mungoP/ZABKA/README.md

# Ż.A.B.K.A.

**Zero-moment Assisted Bipedal Kinetic Android**

ŻABKA ("little frog" in Polish) is a DIY 3D-printed humanoid robot. The current focus is the legs.

## Planned Specs

- **Height:** 3-4 ft
- **Legs:** 6 DoF each (3 hip, 1 knee, 2 ankle), 12 DoF total
- **Actuators:** Integrated motors with built-in drivers, controlled over CAN
- **Structure:** PETG, 4 walls, 10-20% infill
- **Power:** 48V Li-ion battery
- **Estimated weight:** 14-18 kg without arms

## Status

Early planning: selecting motors and finalizing the leg design.
