mungoP/ZABKA/docs/README.md

# Docs

Datasheets, reference material, and images.
