mungoP/ZABKA/firmware/README.md

# Firmware

Firmware for both the main board as well as the individual motor controller/IMU boards.
