mungoP/ZABKA/pcb/README.md

# PCB

Contains both KiCad files for the main board and motor controller/IMU boards as well as gerber files for ordering from a PCB manufacturer.
