mungoP/ZABKA/pcb/motor_board/update-symbols-from-library-report.txt

Update symbol C22 from 'PCM_JLCPCB-Capacitors:0402,100nF' to 'PCM_JLCPCB-Capacitors:0402,100nF': OK
Update symbol R13 from 'PCM_JLCPCB-Resistors:0402,120Ω' to 'PCM_JLCPCB-Resistors:0402,120Ω': OK
Update symbol JP1 from 'Jumper:SolderJumper_2_Open' to 'Jumper:SolderJumper_2_Open': OK
Update symbol U5 from 'zabka:AS5047P-ATSM_C962063' to 'zabka:AS5047P-ATSM_C962063': OK
Update symbol C21 from 'PCM_JLCPCB-Capacitors:0402,100nF' to 'PCM_JLCPCB-Capacitors:0402,100nF': OK
Update symbol U2 from 'zabka:TCAN3414DR' to 'zabka:TCAN3414DR': OK
Update symbol R18 from 'PCM_JLCPCB-Resistors:0402,33Ω' to 'PCM_JLCPCB-Resistors:0402,33Ω': OK
Update symbol D4 from 'zabka:PESD1CAN,215' to 'zabka:PESD1CAN,215': OK
Update symbol U3 from 'zabka:SM04B-GHS-TB' to 'zabka:SM04B-GHS-TB': OK
Update symbol #PWR045 from 'power:+3V3' to 'power:+3V3': OK
Update symbol #PWR044 from 'power:GND' to 'power:GND': OK
Update symbol C23 from 'PCM_JLCPCB-Capacitors:0402,1uF' to 'PCM_JLCPCB-Capacitors:0402,1uF': OK
Update symbol C20 from 'PCM_JLCPCB-Capacitors:0402,4.7nF' to 'PCM_JLCPCB-Capacitors:0402,4.7nF': OK
Update symbol R17 from 'PCM_JLCPCB-Resistors:0402,10kΩ' to 'PCM_JLCPCB-Resistors:0402,10kΩ': OK
Update symbol #PWR019 from 'power:+3V3' to 'power:+3V3': OK
Update symbol #PWR038 from 'power:GND' to 'power:GND': OK
Update symbol #PWR037 from 'power:+3V3' to 'power:+3V3': OK
Update symbol #PWR027 from 'power:+3V3' to 'power:+3V3': OK
Update symbol #PWR07 from 'power:+3V3' to 'power:+3V3': OK
Update symbol #PWR011 from 'power:GND' to 'power:GND': OK
Update symbol #PWR024 from 'zabka:VM' to 'zabka:VM': OK
Update symbol #PWR025 from 'zabka:PGND' to 'zabka:PGND': OK
Update symbol C14 from 'PCM_JLCPCB-Capacitors:0805,4.7uF' to 'PCM_JLCPCB-Capacitors:0805,4.7uF': OK
Update symbol X1 from 'PCM_JLCPCB-Crystals:Crystal, 25MHz, 11pF' to 'PCM_JLCPCB-Crystals:Crystal, 25MHz, 11pF': OK
Update symbol J1 from 'Connector:Conn_01x05_Pin' to 'Connector:Conn_01x05_Pin': OK
Update symbol C9 from 'PCM_JLCPCB-Capacitors:1206,22uF,(2)' to 'PCM_JLCPCB-Capacitors:1206,22uF,(2)': OK
Update symbol C11 from 'PCM_JLCPCB-Capacitors:0402,100nF' to 'PCM_JLCPCB-Capacitors:0402,100nF': OK
Update symbol R7 from 'PCM_JLCPCB-Resistors:1206,100Ω' to 'PCM_JLCPCB-Resistors:1206,100Ω': OK
Update symbol #PWR018 from 'power:VCC' to 'power:VCC': OK
Update symbol C3 from 'PCM_JLCPCB-Capacitors:0402,100nF' to 'PCM_JLCPCB-Capacitors:0402,100nF': OK
Update symbol #PWR012 from 'power:GND' to 'power:GND': OK
Update symbol C6 from 'PCM_JLCPCB-Capacitors:0805,100nF' to 'PCM_JLCPCB-Capacitors:0805,100nF': OK
Update symbol #PWR021 from 'zabka:VM' to 'zabka:VM': OK
Update symbol #PWR026 from 'power:VCC' to 'power:VCC': OK
Update symbol #PWR04 from 'power:VDDA' to 'power:VDDA': OK
Update symbol FB1 from 'PCM_JLCPCB-Inductors:Ferrite,0603' to 'PCM_JLCPCB-Inductors:Ferrite,0603': OK
Update symbol #PWR010 from 'power:GND' to 'power:GND': OK
Update symbol U1 from 'zabka:STSPIN32G4_C7434864' to 'zabka:STSPIN32G4_C7434864': OK
Update symbol C8 from 'PCM_JLCPCB-Capacitors:0402,100nF' to 'PCM_JLCPCB-Capacitors:0402,100nF': OK
Update symbol #PWR03 from 'zabka:PGND' to 'zabka:PGND': OK
Update symbol #FLG01 from 'power:PWR_FLAG' to 'power:PWR_FLAG': OK
Update symbol R6 from 'PCM_JLCPCB-Resistors:1206,100Ω' to 'PCM_JLCPCB-Resistors:1206,100Ω': OK
Update symbol C5 from 'PCM_JLCPCB-Capacitors:0603,10uF' to 'PCM_JLCPCB-Capacitors:0603,10uF': OK
Update symbol R5 from 'PCM_JLCPCB-Resistors:0402,100kΩ' to 'PCM_JLCPCB-Resistors:0402,100kΩ': OK
Update symbol C2 from 'PCM_JLCPCB-Capacitors:0402,15pF' to 'PCM_JLCPCB-Capacitors:0402,15pF': OK
Update symbol #PWR023 from 'power:GND' to 'power:GND': OK
Update symbol C1 from 'PCM_JLCPCB-Capacitors:0402,15pF' to 'PCM_JLCPCB-Capacitors:0402,15pF': OK
Update symbol R1 from 'PCM_JLCPCB-Resistors:0402,1kΩ' to 'PCM_JLCPCB-Resistors:0402,1kΩ': OK
Update symbol #PWR08 from 'zabka:PGND' to 'zabka:PGND': OK
Update symbol #PWR017 from 'power:GND' to 'power:GND': OK
Update symbol R8 from 'PCM_JLCPCB-Resistors:1206,100Ω' to 'PCM_JLCPCB-Resistors:1206,100Ω': OK
Update symbol #PWR014 from 'power:GND' to 'power:GND': OK
Update symbol #PWR06 from 'power:VDDA' to 'power:VDDA': OK
Update symbol C15 from 'PCM_JLCPCB-Capacitors:0402,1uF' to 'PCM_JLCPCB-Capacitors:0402,1uF': OK
Update symbol C4 from 'PCM_JLCPCB-Capacitors:0402,100nF' to 'PCM_JLCPCB-Capacitors:0402,100nF': OK
Update symbol L1 from 'zabka:FNR6020S180MT' to 'zabka:FNR6020S180MT': OK
Update symbol R4 from 'PCM_JLCPCB-Resistors:0402,10kΩ' to 'PCM_JLCPCB-Resistors:0402,10kΩ': OK
Update symbol C7 from 'PCM_JLCPCB-Capacitors:0805,100nF' to 'PCM_JLCPCB-Capacitors:0805,100nF': OK
Update symbol #PWR01 from 'power:VDDA' to 'power:VDDA': OK
Update symbol #PWR02 from 'power:GND' to 'power:GND': OK
Update symbol #PWR020 from 'power:VCC' to 'power:VCC': OK
Update symbol D1 from 'PCM_JLCPCB-Diodes:LED,0603,Red' to 'PCM_JLCPCB-Diodes:LED,0603,Red': OK
Update symbol C13 from 'PCM_JLCPCB-Capacitors:0402,100nF' to 'PCM_JLCPCB-Capacitors:0402,100nF': OK
Update symbol C10 from 'PCM_JLCPCB-Capacitors:1206,22uF,(2)' to 'PCM_JLCPCB-Capacitors:1206,22uF,(2)': OK
Update symbol #PWR016 from 'power:GND' to 'power:GND': OK
Update symbol R3 from 'PCM_JLCPCB-Resistors:0402,22kΩ' to 'PCM_JLCPCB-Resistors:0402,22kΩ': OK
Update symbol R2 from 'PCM_JLCPCB-Resistors:0402,10kΩ' to 'PCM_JLCPCB-Resistors:0402,10kΩ': OK
Update symbol #PWR05 from 'power:GND' to 'power:GND': OK
Update symbol #FLG02 from 'power:PWR_FLAG' to 'power:PWR_FLAG': OK
Update symbol C12 from 'PCM_JLCPCB-Capacitors:0402,1uF' to 'PCM_JLCPCB-Capacitors:0402,1uF': OK
Update symbol #PWR013 from 'power:GND' to 'power:GND': OK
Update symbol D2 from 'Diode:SS210' to 'Diode:SS210': OK
Update symbol #PWR09 from 'power:GND' to 'power:GND': OK
Update symbol #PWR029 from 'zabka:VM' to 'zabka:VM': OK
Update symbol TH1 from 'Device:Thermistor_NTC' to 'Device:Thermistor_NTC': OK
Update symbol #PWR034 from 'power:GND' to 'power:GND': OK
Update symbol D3 from 'PCM_JLCPCB-Diodes:TVS-Bi,SMCJ54CA' to 'PCM_JLCPCB-Diodes:TVS-Bi,SMCJ54CA': OK
Update symbol #PWR031 from 'zabka:VM' to 'zabka:VM': OK
Update symbol J2 from 'Connector:Conn_01x02_Pin' to 'Connector:Conn_01x02_Pin': OK
Update symbol R11 from 'PCM_JLCPCB-Resistors:0603,75kΩ' to 'PCM_JLCPCB-Resistors:0603,75kΩ': OK
Update symbol #PWR032 from 'zabka:PGND' to 'zabka:PGND': OK
Update symbol #PWR035 from 'zabka:VM' to 'zabka:VM': OK
Update symbol J3 from 'Connector:Conn_01x02_Pin' to 'Connector:Conn_01x02_Pin': OK
Update symbol C17 from 'zabka:NXA63VB470M12.5*25_LO' to 'zabka:NXA63VB470M12.5*25_LO': OK
Update symbol C18 from 'PCM_JLCPCB-Capacitors:0603,33nF' to 'PCM_JLCPCB-Capacitors:0603,33nF': OK
Update symbol #FLG03 from 'power:PWR_FLAG' to 'power:PWR_FLAG': OK
Update symbol R9 from 'PCM_JLCPCB-Resistors:0402,10kΩ' to 'PCM_JLCPCB-Resistors:0402,10kΩ': OK
Update symbol C19 from 'PCM_JLCPCB-Capacitors:0603,33nF' to 'PCM_JLCPCB-Capacitors:0603,33nF': OK
Update symbol R10 from 'PCM_JLCPCB-Resistors:0402,10kΩ' to 'PCM_JLCPCB-Resistors:0402,10kΩ': OK
Update symbol TP1 from 'Connector:TestPoint' to 'Connector:TestPoint': OK
Update symbol #PWR028 from 'power:GND' to 'power:GND': OK
Update symbol #PWR030 from 'zabka:PGND' to 'zabka:PGND': OK
Update symbol TP2 from 'Connector:TestPoint' to 'Connector:TestPoint': OK
Update symbol C16 from 'PCM_JLCPCB-Capacitors:0603,33nF' to 'PCM_JLCPCB-Capacitors:0603,33nF': OK
Update symbol R12 from 'PCM_JLCPCB-Resistors:0603,3kΩ' to 'PCM_JLCPCB-Resistors:0603,3kΩ': OK
Update symbol #PWR036 from 'power:GND' to 'power:GND': OK
Update symbol #FLG04 from 'power:PWR_FLAG' to 'power:PWR_FLAG': OK
Update symbol #PWR039 from 'power:GND' to 'power:GND': OK
Update symbol U4 from 'zabka:SM04B-GHS-TB' to 'zabka:SM04B-GHS-TB': OK
Update symbol #PWR041 from 'power:GND' to 'power:GND': OK
Update symbol #PWR040 from 'power:GND' to 'power:GND': OK
Update symbol #PWR049 from 'power:+3V3' to 'power:+3V3': OK
Update symbol #PWR046 from 'power:+3V3' to 'power:+3V3': OK
Update symbol R19 from 'PCM_JLCPCB-Resistors:0402,33Ω' to 'PCM_JLCPCB-Resistors:0402,33Ω': OK
Update symbol #PWR048 from 'power:GND' to 'power:GND': OK
Update symbol #PWR042 from 'power:GND' to 'power:GND': OK
Update symbol #PWR022 from 'power:+3V3' to 'power:+3V3': OK
Update symbol #PWR033 from 'power:+3V3' to 'power:+3V3': OK
Update symbol #PWR015 from 'power:+3V3' to 'power:+3V3': OK
Update symbol R20 from 'PCM_JLCPCB-Resistors:0402,33Ω' to 'PCM_JLCPCB-Resistors:0402,33Ω': OK
Update symbol #PWR047 from 'power:GND' to 'power:GND': OK
Update symbol R15 from 'PCM_JLCPCB-Resistors:0402,120Ω' to 'PCM_JLCPCB-Resistors:0402,120Ω': OK
Update symbol R16 from 'PCM_JLCPCB-Resistors:0402,120Ω' to 'PCM_JLCPCB-Resistors:0402,120Ω': OK
Update symbol R14 from 'PCM_JLCPCB-Resistors:0402,120Ω' to 'PCM_JLCPCB-Resistors:0402,120Ω': OK
Update symbol JP2 from 'Jumper:SolderJumper_2_Open' to 'Jumper:SolderJumper_2_Open': OK
Update symbol #PWR043 from 'power:GND' to 'power:GND': OK
