mungoP/ZABKA/docs/ZABKA_sketch1.jpeg

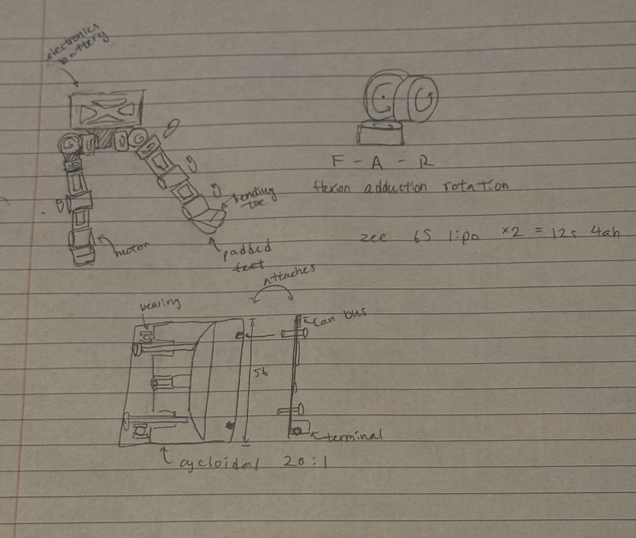
docs/ZABKA_sketch1.jpeg
