mungoP/ZABKA/BOM_ggl_sheet.md

# BOM File

Link to Google sheets BOM csv (to keep cell math formulas)

https://docs.google.com/spreadsheets/d/1IvTHRRW_kaQCn1X5jmZqQL5CsmA0eXGoDoHb6eFF2dk/edit?gid=0#gid=0
