mungoP/ZABKA/BOM.csv

Part | Price | Quantity | Total Price
MAD 5008 170KV BLDC Motor | $75.99 | 10 | $759.90
6S Lipo Battery 4000mAh 22.2V | $122.99 | 1 | $122.99
 |  |  | $0.00
 |  |  | $0.00
 |  |  | $0.00
 |  |  | $0.00
 |  |  | $0.00
 |  |  | $0.00
 |  |  | $0.00
 |  |  | $0.00
 |  |  | $0.00
 |  |  | $0.00
 |  |  | $0.00
