mungoP/ZABKA/pcb/motor_board/motor_board.csv

Reference | Qty | Value | DNP | Exclude from BOM | Exclude from Board | Footprint | Datasheet
C1,C2 | 2 | 15pF |  |  |  | PCM_JLCPCB:C_0402 | https://www.lcsc.com/datasheet/lcsc_datasheet_2304140030_FH--Guangdong-Fenghua-Advanced-Tech-0402CG150J500NT_C1548.pdf
C3,C4,C8,C11,C13,C21,C22 | 7 | 100nF |  |  |  | PCM_JLCPCB:C_0402 | https://www.lcsc.com/datasheet/lcsc_datasheet_2304140030_Samsung-Electro-Mechanics-CL05B104KO5NNNC_C1525.pdf
C5 | 1 | 10uF |  |  |  | PCM_JLCPCB:C_0603 | https://www.lcsc.com/datasheet/lcsc_datasheet_2304140030_Samsung-Electro-Mechanics-CL10A106KP8NNNC_C19702.pdf
C6,C7,C103,C203,C303 | 5 | 100nF |  |  |  | PCM_JLCPCB:C_0805 | https://www.lcsc.com/datasheet/lcsc_datasheet_2304140030_Samsung-Electro-Mechanics-CL21B104KCFNNNE_C28233.pdf
C9,C10 | 2 | 22uF |  |  |  | PCM_JLCPCB:C_1206 | https://www.lcsc.com/datasheet/lcsc_datasheet_2304140030_Samsung-Electro-Mechanics-CL31A226KAHNNNE_C12891.pdf
C12,C15,C23 | 3 | 1uF |  |  |  | PCM_JLCPCB:C_0402 | https://www.lcsc.com/datasheet/lcsc_datasheet_2304140030_Samsung-Electro-Mechanics-CL05A105KA5NQNC_C52923.pdf
C14 | 1 | 4.7uF |  |  |  | PCM_JLCPCB:C_0805 | https://www.lcsc.com/datasheet/lcsc_datasheet_2304140030_Samsung-Electro-Mechanics-CL21A475KAQNNNE_C1779.pdf
C16,C18,C19 | 3 | 33nF |  |  |  | PCM_JLCPCB:C_0603 | https://www.lcsc.com/datasheet/lcsc_datasheet_2304140030_Samsung-Electro-Mechanics-CL10B333KB8NNNC_C21117.pdf
C17 | 1 | NXA63VB470M12.5*25_LO |  |  |  | zabka:CAP-TH_BD12.5-P5.00-D0.6-FD | https://lcsc.com/product-detail/Others_SamYoung-Electronics-NXA63VB470M12-5-25-LO_C371297.html
C20 | 1 | 4.7nF |  |  |  | PCM_JLCPCB:C_0402 | https://www.lcsc.com/datasheet/lcsc_datasheet_2304140030_FH--Guangdong-Fenghua-Advanced-Tech-0402B472K500NT_C1538.pdf
C101,C102,C201,C202,C301,C302 | 6 | 4.7uF |  |  |  | zabka:C1210 | https://lcsc.com/product-detail/Others_Holy-Stone-Enterprise-C1210X475K101T_C337978.html
C104,C204,C304 | 3 | 1uF |  |  |  | PCM_JLCPCB:C_0603 | https://www.lcsc.com/datasheet/lcsc_datasheet_2304140030_Samsung-Electro-Mechanics-CL10A105KB8NNNC_C15849.pdf
D1 | 1 | Red |  |  |  | PCM_JLCPCB:D_0603 | https://www.lcsc.com/datasheet/lcsc_datasheet_1810231112_Hubei-KENTO-Elec-KT-0603R_C2286.pdf
D2 | 1 | SS210 |  |  |  | Diode_SMD:D_SMA | https://www.wontop.com/uploadfiles/56/sort_excel/pdf/ss22.pdf
D3 | 1 | SMCJ54CA |  |  |  | PCM_JLCPCB:D_SMC | https://www.lcsc.com/datasheet/lcsc_datasheet_2501071555_hongjiacheng-SMCJ54CA_C41411761.pdf
D4 | 1 | PESD1CAN,215 |  |  |  | zabka:SOT-23_L2.9-W1.3-P1.90-LS2.4-BR | https://lcsc.com/product-detail/Diodes-ESD_NXP_PESD1CAN_PESD1CAN_C15771.html
FB1 | 1 |  |  |  |  | PCM_JLCPCB:FB_0603 | https://www.lcsc.com/datasheet/lcsc_datasheet_2310301640_Sunlord-GZ1608D601TF_C1002.pdf
J1 | 1 | Conn_01x05_Pin
J2 | 1 | Conn_01x02_Pin |  |  |  | Connector_AMASS:AMASS_XT30PW-M_1x02_P2.50mm_Horizontal
J3 | 1 | Conn_01x02_Pin
L1 | 1 | 18uH |  |  |  | zabka:IND-SMD_L6.0-W6.0_FNR60XXS | https://lcsc.com/product-detail/Power-Inductors_18uH-20-1-08A_C168016.html
Q101,Q102,Q201,Q202,Q301,Q302 | 6 | HYG053N10NS1C2 |  |  |  | zabka:PDFN-8_L5.8-W5.0-P1.27-LS6.2-BL | https://www.lcsc.com/datasheet/C2986239.pdf
R1 | 1 | 1kΩ |  |  |  | PCM_JLCPCB:R_0402 | https://www.lcsc.com/datasheet/lcsc_datasheet_2206010216_UNI-ROYAL-Uniroyal-Elec-0402WGF1001TCE_C11702.pdf
R2,R4,R9,R10,R17 | 5 | 10kΩ |  |  |  | PCM_JLCPCB:R_0402 | https://www.lcsc.com/datasheet/lcsc_datasheet_2411221126_UNI-ROYAL-Uniroyal-Elec-0402WGF1002TCE_C25744.pdf
R3 | 1 | 22kΩ |  |  |  | PCM_JLCPCB:R_0402 | https://www.lcsc.com/datasheet/lcsc_datasheet_2206010100_UNI-ROYAL-Uniroyal-Elec-0402WGF2202TCE_C25768.pdf
R5 | 1 | 100kΩ |  |  |  | PCM_JLCPCB:R_0402 | https://www.lcsc.com/datasheet/lcsc_datasheet_2206010100_UNI-ROYAL-Uniroyal-Elec-0402WGF1003TCE_C25741.pdf
R6,R7,R8 | 3 | 100Ω |  |  |  | PCM_JLCPCB:R_1206 | https://www.lcsc.com/datasheet/lcsc_datasheet_2206010145_UNI-ROYAL-Uniroyal-Elec-1206W4F1000T5E_C17901.pdf
R11 | 1 | 75kΩ |  |  |  | PCM_JLCPCB:R_0603 | https://www.lcsc.com/datasheet/lcsc_datasheet_2206010100_UNI-ROYAL-Uniroyal-Elec-0603WAF7502T5E_C23242.pdf
R12 | 1 | 3kΩ |  |  |  | PCM_JLCPCB:R_0603 | https://www.lcsc.com/datasheet/lcsc_datasheet_2206010230_UNI-ROYAL-Uniroyal-Elec-0603WAF3001T5E_C4211.pdf
R13,R14,R15,R16 | 4 | 120Ω |  |  |  | PCM_JLCPCB:R_0402 | https://www.lcsc.com/datasheet/lcsc_datasheet_2205311900_UNI-ROYAL-Uniroyal-Elec-0402WGF1200TCE_C25079.pdf
R18,R19,R20 | 3 | 33Ω |  |  |  | PCM_JLCPCB:R_0402 | https://www.lcsc.com/datasheet/lcsc_datasheet_2205311900_UNI-ROYAL-Uniroyal-Elec-0402WGF330JTCE_C25105.pdf
R101,R103,R201,R203,R301,R303 | 6 | 22Ω |  |  |  | PCM_JLCPCB:R_0603 | https://www.lcsc.com/datasheet/lcsc_datasheet_2206010100_UNI-ROYAL-Uniroyal-Elec-0603WAF220JT5E_C23345.pdf
R102,R104,R202,R204,R302,R304 | 6 | 47kΩ |  |  |  | PCM_JLCPCB:R_0402 | https://www.lcsc.com/datasheet/lcsc_datasheet_2206010100_UNI-ROYAL-Uniroyal-Elec-0402WGF4702TCE_C25792.pdf
R105,R107,R205,R207,R305,R307 | 6 | 100kΩ |  |  |  | PCM_JLCPCB:R_0603 | https://www.lcsc.com/datasheet/lcsc_datasheet_2206010045_UNI-ROYAL-Uniroyal-Elec-0603WAF1003T5E_C25803.pdf
R106,R109,R206,R209,R306,R309 | 6 | 1.5kΩ |  |  |  | PCM_JLCPCB:R_0603 | https://www.lcsc.com/datasheet/lcsc_datasheet_2206010130_UNI-ROYAL-Uniroyal-Elec-0603WAF1501T5E_C22843.pdf
R108,R208,R308 | 3 | SHUNT_R |  |  |  | zabka:RES-SMD_L6.4-W3.2_LR2512D-3W-1MR | https://lcsc.com/product-detail/Low-Resistors-Current-Sense-Resistors-Surface-Mount_Milliohm-LR2512D-3W-1mR-1_C500734.html
R110,R210,R310 | 3 | 49.9kΩ |  |  |  | PCM_JLCPCB:R_0402 | https://www.lcsc.com/datasheet/lcsc_datasheet_2206010045_UNI-ROYAL-Uniroyal-Elec-0402WGF4992TCE_C25897.pdf
TH1 | 1 | Thermistor_NTC
TP1,TP2 | 2 | TestPoint
U1 | 1 | STSPIN32G4_C7434864 |  |  |  | zabka:VFQFPN-64_L9.0-W9.0-P0.50-TL-EP4.0 | https://www.lcsc.com/datasheet/C7434864.pdf
U2 | 1 | TCAN3414DR |  |  |  | zabka:SOIC-8_L4.9-W3.9-P1.27-LS6.0-BL | https://www.lcsc.com/datasheet/C22396693.pdf
U3,U4 | 2 | SM04B-GHS-TB |  |  |  | zabka:CONN-SMD_4P-P1.25_SM04B-GHS-TB-LF-SN | https://lcsc.com/product-detail/Connectors_JST-Sales-America_SM04B-GHS-TB-LF-SN_JST-Sales-America-SM04B-GHS-TB-LF-SN_C189895.html
U5 | 1 | AS5047P-ATSM |  |  |  | zabka:TSSOP-14_L5.0-W4.4-P0.65-LS6.4-BL | https://www.lcsc.com/datasheet/C962063.pdf
X1 | 1 | X322525MOB4SI |  |  |  | PCM_JLCPCB:OSC-SMD_4P-L3.2-W2.5-BL | https://www.lcsc.com/datasheet/lcsc_datasheet_2403291504_YXC-Crystal-Oscillators-X322525MOB4SI_C9006.pdf
