mungoP/ZABKA/cad/assembly/README.md

# CAD

[Open the Onshape project](https://cad.onshape.com/documents/36b9c1c47c9663627730077e/w/f549ec7524befbafc4d76888/e/eeef4c7501a8bac773f10d7f)

STEP exports for each part are in [`step/`](step/).
