mungoP/ZABKA/pcb/motor_board/motor_board.kicad_pcb

## KiCad design pcb/motor_board/motor_board.kicad_pcb (2026-11-13)

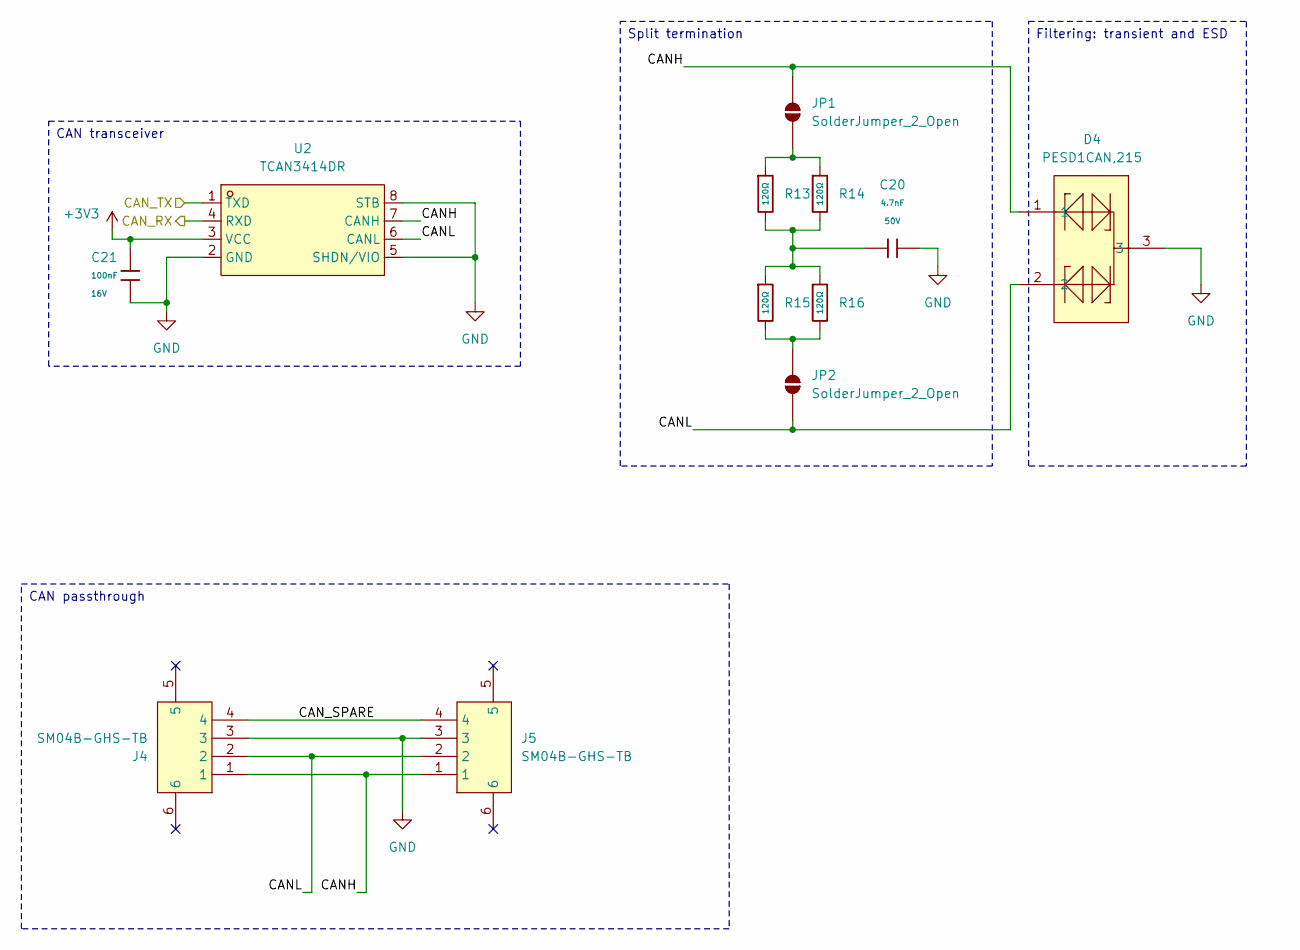
[picture p2: schematic CAN_bus.kicad_sch]

Parts:
C20: 4.7nF; C_0402; Voltage Rated 50V; Tolerance ±10%; Part 0402B472K500NT; LCSC C1538
C21: 100nF; C_0402; Voltage Rated 16V; Tolerance ±10%; Part CL05B104KO5NNNC; LCSC C1525
D4: PESD1CAN,215; SOT-23_L2.9-W1.3-P1.90-LS2.4-BR; MPN PESD1CAN,215; LCSC Part C15771
J4, J5: SM04B-GHS-TB; CONN-SMD_4P-P1.25_SM04B-GHS-TB-LF-SN; MPN SM04B-GHS-TB(LF)(SN); LCSC Part C189895
JP1, JP2: SolderJumper_2_Open; SolderJumper-2_P1.3mm_Open_Pad1.0x1.5mm
R13, R14, R15, R16: 120Ω; R_0402; Overload Voltage (Max) 50V; Tolerance ±1%; Part 0402WGF1200TCE; LCSC C25079
U2: TCAN3414DR; SOIC-8_L4.9-W3.9-P1.27-LS6.0-BL; MPN TCAN3414DR; LCSC Part C22396693

Connections:
+3V3: C21.1, U2.3 (VCC); also elsewhere on the board
/CAN bus/CANH: D4.1, J4.1, J5.1, JP1.2 (B), U2.7 (CANH)
/CAN bus/CANL: D4.2, J4.2, J5.2, JP2.1 (A), U2.6 (CANL)
/CAN bus/CAN_RX: U2.4 (RXD); also elsewhere on the board
/CAN bus/CAN_SPARE: J4.4, J5.4
/CAN bus/CAN_TX: U2.1 (TXD); also elsewhere on the board
GND: C20.2, C21.2, D4.3, J4.3, J5.3, U2.2 (GND), U2.5 (SHDN/VIO), U2.8 (STB); also elsewhere on the board
unnamed: C20.1, R13.2, R14.2, R15.1, R16.1
unnamed: JP1.1 (A), R13.1, R14.1
unnamed: JP2.2 (B), R15.2, R16.2

Notes on the sheet:
Split termination
CAN transceiver
CAN passthrough
Filtering: transient and ESD

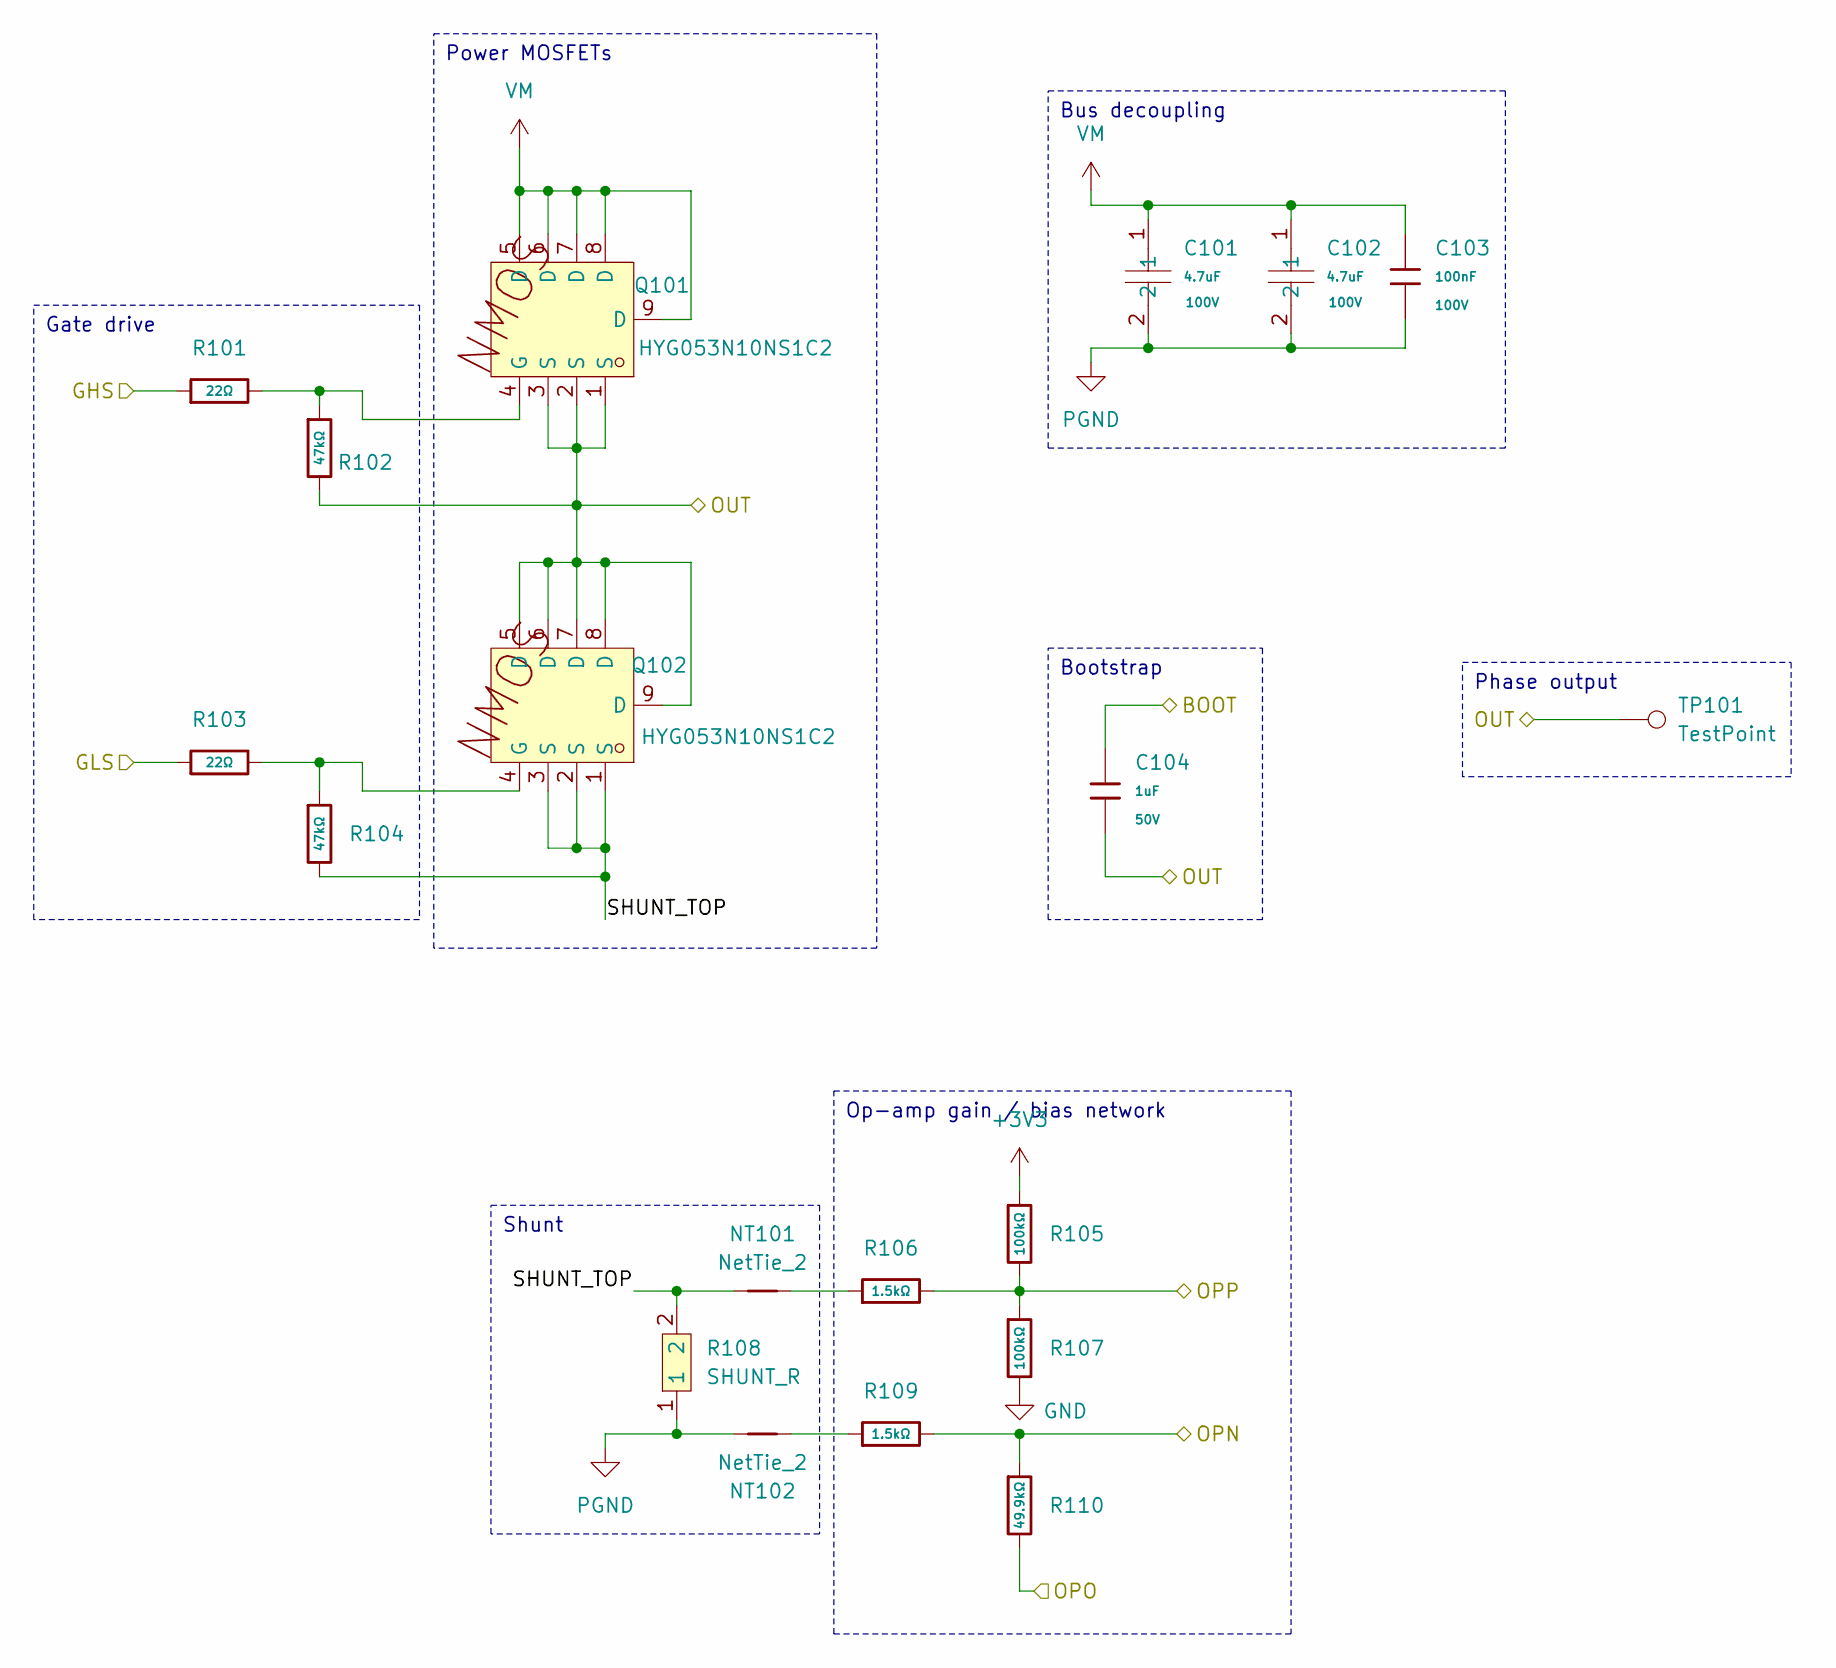
[picture p3: schematic half_bridge.kicad_sch]

Parts:
C101, C102: 4.7uF; C1210; MPN C1210X475K101T; LCSC Part C337978
C103: 100nF; C_0805; Voltage Rated 100V; Tolerance ±10%; Part CL21B104KCFNNNE; LCSC C28233
C104: 1uF; C_0603; Voltage Rated 50V; Tolerance ±10%; Part CL10A105KB8NNNC; LCSC C15849
NT101, NT102: NetTie_2; NetTie-2_SMD_Pad0.5mm
Q101, Q102: HYG053N10NS1C2; PDFN-8_L5.8-W5.0-P1.27-LS6.2-BL; MPN HYG053N10NS1C2; LCSC Part C2986239
R101, R103: 22Ω; R_0603; Overload Voltage (Max) 75V; Tolerance ±1%; Part 0603WAF220JT5E; LCSC C23345
R102, R104: 47kΩ; R_0402; Overload Voltage (Max) 50V; Tolerance ±1%; Part 0402WGF4702TCE; LCSC C25792
R105, R107: 100kΩ; R_0603; Overload Voltage (Max) 75V; Tolerance ±1%; Part 0603WAF1003T5E; LCSC C25803
R106, R109: 1.5kΩ; R_0603; Overload Voltage (Max) 75V; Tolerance ±1%; Part 0603WAF1501T5E; LCSC C22843
R108: SHUNT_R; RES-SMD_L6.4-W3.2_LR2512D-3W-1MR; MPN LR2512D-3W-1mR-1%; LCSC Part C500734
R110: 49.9kΩ; R_0402; Overload Voltage (Max) 50V; Tolerance ±1%; Part 0402WGF4992TCE; LCSC C25897
TP101: TestPoint; TestPoint_Pad_4.0x4.0mm

Connections:
+3V3: R105.1; also elsewhere on the board
/Controller/BOOT1: C104.1; also elsewhere on the board
/Controller/GHS1: R101.1; also elsewhere on the board
/Controller/GLS1: R103.1; also elsewhere on the board
/Controller/OPN1: R109.2, R110.1; also elsewhere on the board
/Controller/OPO1: R110.2; also elsewhere on the board
/Controller/OPP1: R105.2, R106.2, R107.1; also elsewhere on the board
/Controller/OUT1: C104.2, Q101.1 (S), Q101.2 (S), Q101.3 (S), Q102.5 (D), Q102.6 (D), Q102.7 (D), Q102.8 (D), Q102.9 (D), R102.2, TP101.1 (1_1); also elsewhere on the board
/Half bridge - U/SHUNT_TOP: NT101.1, Q102.1 (S), Q102.2 (S), Q102.3 (S), R104.2, R108.2
GND: R107.2; also elsewhere on the board
unnamed: NT101.2, R106.1
unnamed: NT102.1, R109.1
unnamed: Q101.4 (G), R101.2, R102.1
unnamed: Q102.4 (G), R103.2, R104.1
PGND: C101.2, C102.2, C103.2, NT102.2, R108.1; also elsewhere on the board
VM: C101.1, C102.1, C103.1, Q101.5 (D), Q101.6 (D), Q101.7 (D), Q101.8 (D), Q101.9 (D); also elsewhere on the board

Parts of its further copies:
C201, C202, C301, C302: 4.7uF; C1210; MPN C1210X475K101T; LCSC Part C337978
C203, C303: 100nF; C_0805; Voltage Rated 100V; Tolerance ±10%; Part CL21B104KCFNNNE; LCSC C28233
C204, C304: 1uF; C_0603; Voltage Rated 50V; Tolerance ±10%; Part CL10A105KB8NNNC; LCSC C15849
NT201, NT202, NT301, NT302: NetTie_2; NetTie-2_SMD_Pad0.5mm
Q201, Q202, Q301, Q302: HYG053N10NS1C2; PDFN-8_L5.8-W5.0-P1.27-LS6.2-BL; MPN HYG053N10NS1C2; LCSC Part C2986239
R201, R203, R301, R303: 22Ω; R_0603; Overload Voltage (Max) 75V; Tolerance ±1%; Part 0603WAF220JT5E; LCSC C23345
R202, R204, R302, R304: 47kΩ; R_0402; Overload Voltage (Max) 50V; Tolerance ±1%; Part 0402WGF4702TCE; LCSC C25792
R205, R207, R305, R307: 100kΩ; R_0603; Overload Voltage (Max) 75V; Tolerance ±1%; Part 0603WAF1003T5E; LCSC C25803
R206, R209, R306, R309: 1.5kΩ; R_0603; Overload Voltage (Max) 75V; Tolerance ±1%; Part 0603WAF1501T5E; LCSC C22843
R208, R308: SHUNT_R; RES-SMD_L6.4-W3.2_LR2512D-3W-1MR; MPN LR2512D-3W-1mR-1%; LCSC Part C500734
R210, R310: 49.9kΩ; R_0402; Overload Voltage (Max) 50V; Tolerance ±1%; Part 0402WGF4992TCE; LCSC C25897
TP201, TP301: TestPoint; TestPoint_Pad_4.0x4.0mm

Connections of its further copies:
+3V3: R205.1, R305.1; also elsewhere on the board
/Controller/BOOT2: C204.1; also elsewhere on the board
/Controller/BOOT3: C304.1; also elsewhere on the board
/Controller/GHS2: R201.1; also elsewhere on the board
/Controller/GHS3: R301.1; also elsewhere on the board
/Controller/GLS2: R203.1; also elsewhere on the board
/Controller/GLS3: R303.1; also elsewhere on the board
/Controller/OPN2: R209.2, R210.1; also elsewhere on the board
/Controller/OPN3: R309.2, R310.1; also elsewhere on the board
/Controller/OPO2: R210.2; also elsewhere on the board
/Controller/OPO3: R310.2; also elsewhere on the board
/Controller/OPP2: R205.2, R206.2, R207.1; also elsewhere on the board
/Controller/OPP3: R305.2, R306.2, R307.1; also elsewhere on the board
/Controller/OUT2: C204.2, Q201.1 (S), Q201.2 (S), Q201.3 (S), Q202.5 (D), Q202.6 (D), Q202.7 (D), Q202.8 (D), Q202.9 (D), R202.2, TP201.1 (1_1); also elsewhere on the board
/Controller/OUT3: C304.2, Q301.1 (S), Q301.2 (S), Q301.3 (S), Q302.5 (D), Q302.6 (D), Q302.7 (D), Q302.8 (D), Q302.9 (D), R302.2, TP301.1 (1_1); also elsewhere on the board
/Half bridge - V/SHUNT_TOP: NT201.1, Q202.1 (S), Q202.2 (S), Q202.3 (S), R204.2, R208.2
/Half bridge - W/SHUNT_TOP: NT301.1, Q302.1 (S), Q302.2 (S), Q302.3 (S), R304.2, R308.2
GND: R207.2, R307.2; also elsewhere on the board
unnamed: NT201.2, R206.1
unnamed: NT202.1, R209.1
unnamed: NT301.2, R306.1
unnamed: NT302.1, R309.1
unnamed: Q201.4 (G), R201.2, R202.1
unnamed: Q202.4 (G), R203.2, R204.1
unnamed: Q301.4 (G), R301.2, R302.1
unnamed: Q302.4 (G), R303.2, R304.1
PGND: C201.2, C202.2, C203.2, C301.2, C302.2, C303.2, NT202.2, NT302.2, R208.1, R308.1; also elsewhere on the board
VM: C201.1, C202.1, C203.1, C301.1, C302.1, C303.1, Q201.5 (D), Q201.6 (D), Q201.7 (D), Q201.8 (D), Q201.9 (D), Q301.5 (D), Q301.6 (D), Q301.7 (D), Q301.8 (D), Q301.9 (D); also elsewhere on the board

Notes on the sheet:
Bootstrap
Gate drive
Shunt
Bus decoupling
Power MOSFETs
Op-amp gain / bias network
Phase output

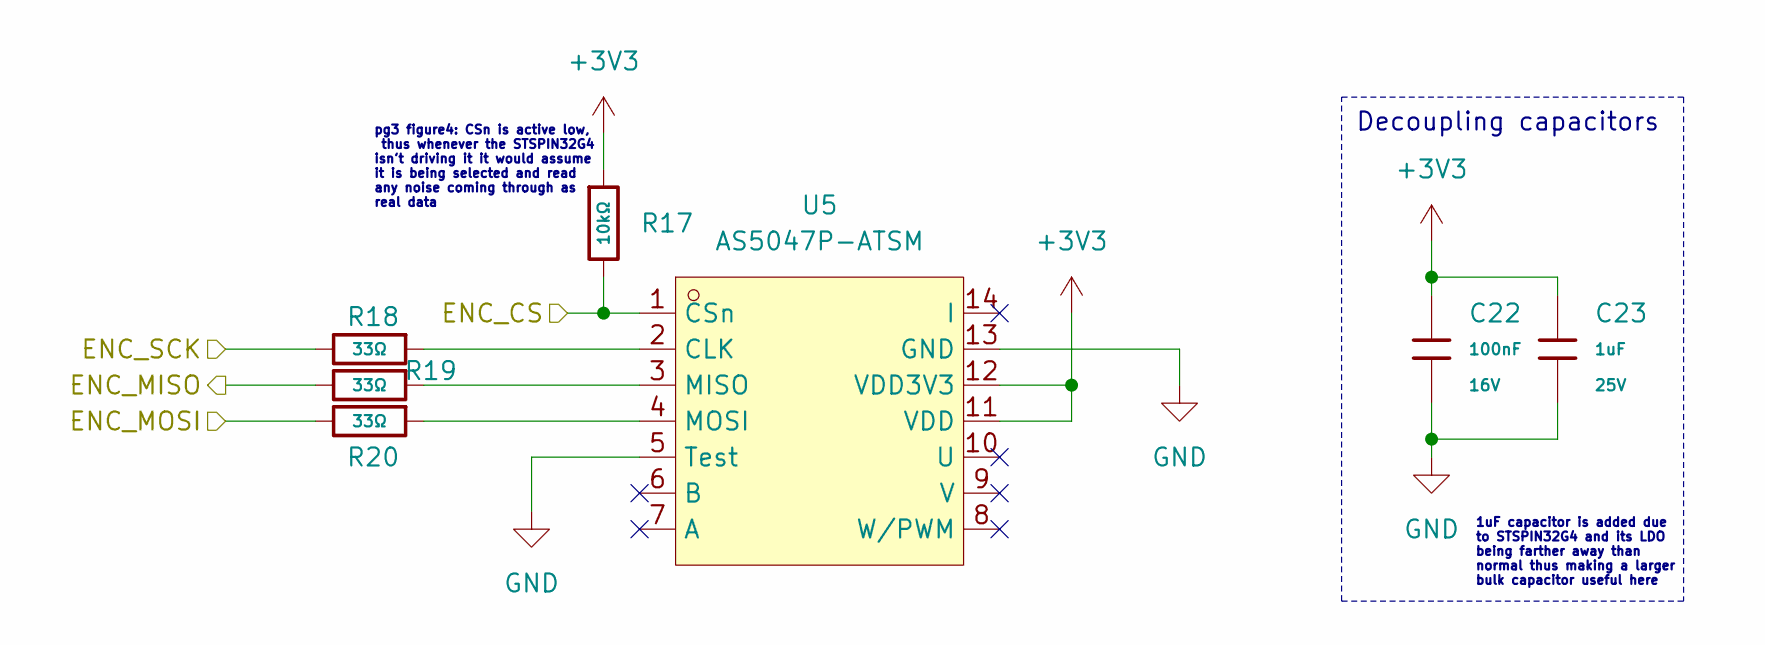
[picture p4: schematic encoder.kicad_sch]

Parts:
C22: 100nF; C_0402; Voltage Rated 16V; Tolerance ±10%; Part CL05B104KO5NNNC; LCSC C1525
C23: 1uF; C_0402; Voltage Rated 25V; Tolerance ±10%; Part CL05A105KA5NQNC; LCSC C52923
R17: 10kΩ; R_0402; Overload Voltage (Max) 50V; Tolerance ±1%; Part 0402WGF1002TCE; LCSC C25744
R18, R19, R20: 33Ω; R_0402; Overload Voltage (Max) 50V; Tolerance ±1%; Part 0402WGF330JTCE; LCSC C25105
U5: AS5047P-ATSM; TSSOP-14_L5.0-W4.4-P0.65-LS6.4-BL; MPN AS5047P-ATSM; LCSC Part C962063

Connections:
+3V3: C22.1, C23.1, R17.1, U5.11 (VDD), U5.12 (VDD3V3); also elsewhere on the board
/Controller/ENC_CS: R17.2, U5.1 (CSn); also elsewhere on the board
/Controller/ENC_MISO: R19.2; also elsewhere on the board
/Controller/ENC_MOSI: R20.2; also elsewhere on the board
/Controller/ENC_SCK: R18.2; also elsewhere on the board
GND: C22.2, C23.2, U5.5 (Test), U5.13 (GND); also elsewhere on the board
unnamed: R18.1, U5.2 (CLK)
unnamed: R19.1, U5.3 (MISO)
unnamed: R20.1, U5.4 (MOSI)

Notes on the sheet:
pg3 figure4: CSn is active low, thus whenever the STSPIN32G4 isn't driving it it would assume it is being selected and read any noise coming through as real data
1uF capacitor is added due to STSPIN32G4 and its LDO being farther away than normal thus making a larger bulk capacitor useful here
Decoupling capacitors

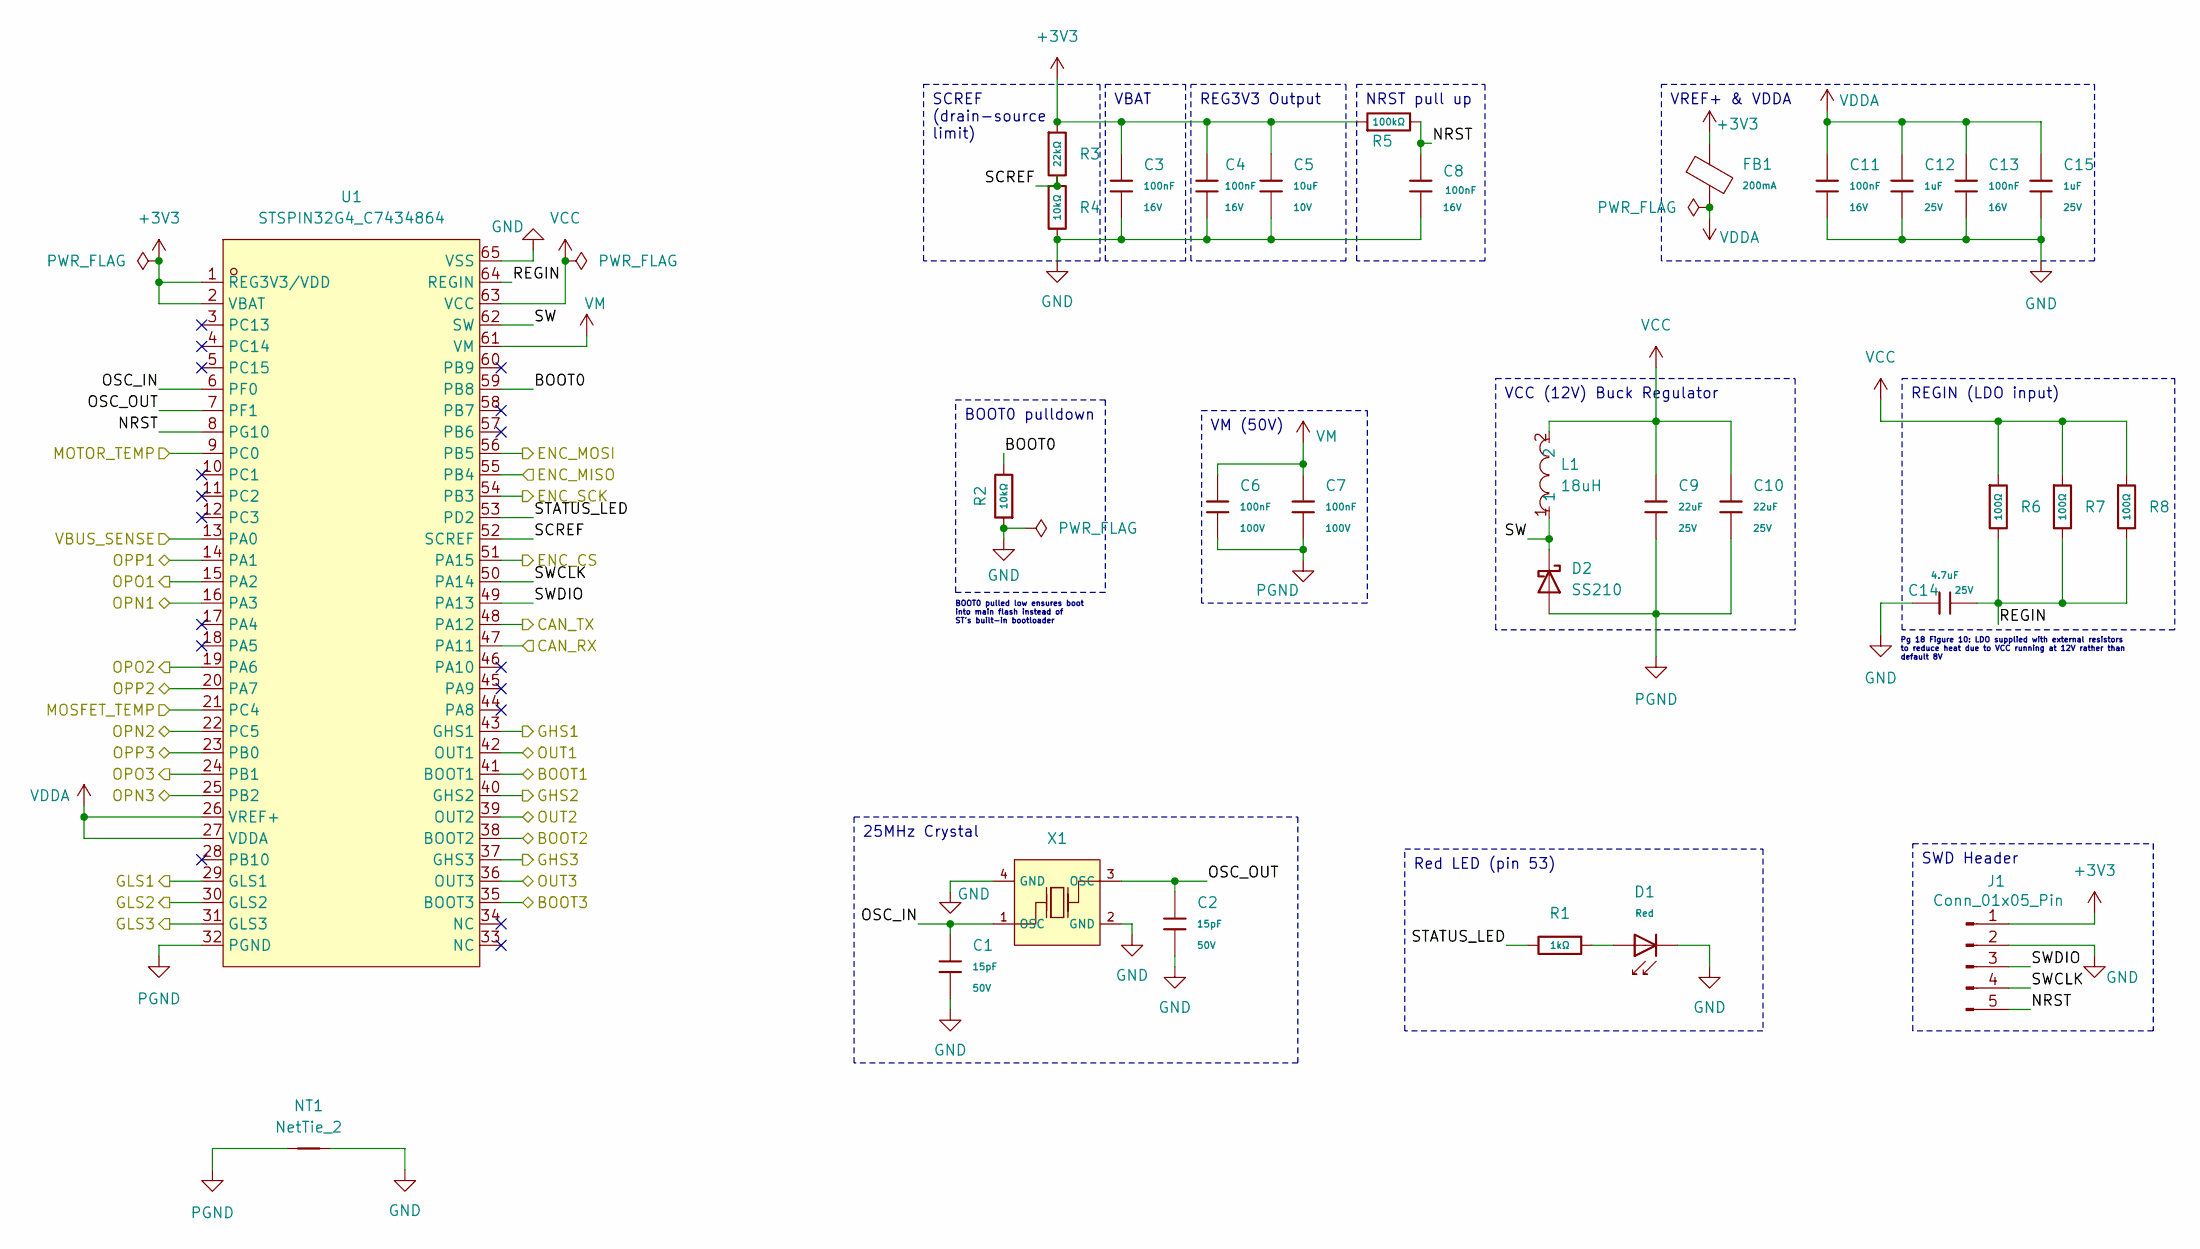
[picture p5: schematic controller.kicad_sch]

Parts:
C1, C2: 15pF; C_0402; Voltage Rated 50V; Tolerance ±5%; Part 0402CG150J500NT; LCSC C1548
C3, C4, C8, C11, C13: 100nF; C_0402; Voltage Rated 16V; Tolerance ±10%; Part CL05B104KO5NNNC; LCSC C1525
C5: 10uF; C_0603; Voltage Rated 10V; Tolerance ±10%; Part CL10A106KP8NNNC; LCSC C19702
C6, C7: 100nF; C_0805; Voltage Rated 100V; Tolerance ±10%; Part CL21B104KCFNNNE; LCSC C28233
C9, C10: 22uF; C_1206; Voltage Rated 25V; Tolerance ±10%; Part CL31A226KAHNNNE; LCSC C12891
C12, C15: 1uF; C_0402; Voltage Rated 25V; Tolerance ±10%; Part CL05A105KA5NQNC; LCSC C52923
C14: 4.7uF; C_0805; Voltage Rated 25V; Tolerance ±10%; Part CL21A475KAQNNNE; LCSC C1779
D1: Red; D_0603; Part KT-0603R; LCSC C2286
D2: SS210; D_SMA
FB1: FB_0603; Current Rating 200mA; Tolerance ±25%; Part GZ1608D601TF; LCSC C1002
J1: Conn_01x05_Pin; PinHeader_1x05_P2.54mm_Horizontal
L1: 18uH; IND-SMD_L6.0-W6.0_FNR60XXS; MPN FNR6020S180MT; LCSC Part C168016
NT1: NetTie_2; NetTie-2_SMD_Pad0.5mm
R1: 1kΩ; R_0402; Overload Voltage (Max) 50V; Tolerance ±1%; Part 0402WGF1001TCE; LCSC C11702
R2, R4: 10kΩ; R_0402; Overload Voltage (Max) 50V; Tolerance ±1%; Part 0402WGF1002TCE; LCSC C25744
R3: 22kΩ; R_0402; Overload Voltage (Max) 50V; Tolerance ±1%; Part 0402WGF2202TCE; LCSC C25768
R5: 100kΩ; R_0402; Overload Voltage (Max) 50V; Tolerance ±1%; Part 0402WGF1003TCE; LCSC C25741
R6, R7, R8: 100Ω; R_1206; Overload Voltage (Max) 200V; Tolerance ±1%; Part 1206W4F1000T5E; LCSC C17901
U1: STSPIN32G4_C7434864; VFQFPN-64_L9.0-W9.0-P0.50-TL-EP4.0; MPN STSPIN32G4; LCSC Part C7434864
X1: X322525MOB4SI; OSC-SMD_4P-L3.2-W2.5-BL; Frequency Tolerance ±10ppm; Part X322525MOB4SI; LCSC C9006

Connections:
+3V3: C3.1, C4.1, C5.1, FB1.1, J1.1, R3.1, R5.1, U1.1 (REG3V3/VDD), U1.2 (VBAT); also elsewhere on the board
/CAN bus/CAN_RX: U1.47 (PA11); also elsewhere on the board
/CAN bus/CAN_TX: U1.48 (PA12); also elsewhere on the board
/Controller/BOOT0: R2.2, U1.59 (PB8)
/Controller/BOOT1: U1.41 (BOOT1); also elsewhere on the board
/Controller/BOOT2: U1.38 (BOOT2); also elsewhere on the board
/Controller/BOOT3: U1.35 (BOOT3); also elsewhere on the board
/Controller/ENC_CS: U1.51 (PA15); also elsewhere on the board
/Controller/ENC_MISO: U1.55 (PB4); also elsewhere on the board
/Controller/ENC_MOSI: U1.56 (PB5); also elsewhere on the board
/Controller/ENC_SCK: U1.54 (PB3); also elsewhere on the board
/Controller/GHS1: U1.43 (GHS1); also elsewhere on the board
/Controller/GHS2: U1.40 (GHS2); also elsewhere on the board
/Controller/GHS3: U1.37 (GHS3); also elsewhere on the board
/Controller/GLS1: U1.29 (GLS1); also elsewhere on the board
/Controller/GLS2: U1.30 (GLS2); also elsewhere on the board
/Controller/GLS3: U1.31 (GLS3); also elsewhere on the board
/Controller/MOSFET_TEMP: U1.21 (PC4); also elsewhere on the board
/Controller/MOTOR_TEMP: U1.9 (PC0); also elsewhere on the board
/Controller/NRST: C8.1, J1.5, R5.2, U1.8 (PG10)
/Controller/OPN1: U1.16 (PA3); also elsewhere on the board
/Controller/OPN2: U1.22 (PC5); also elsewhere on the board
/Controller/OPN3: U1.25 (PB2); also elsewhere on the board
/Controller/OPO1: U1.15 (PA2); also elsewhere on the board
/Controller/OPO2: U1.19 (PA6); also elsewhere on the board
/Controller/OPO3: U1.24 (PB1); also elsewhere on the board
/Controller/OPP1: U1.14 (PA1); also elsewhere on the board
/Controller/OPP2: U1.20 (PA7); also elsewhere on the board
/Controller/OPP3: U1.23 (PB0); also elsewhere on the board
/Controller/OSC_IN: C1.1, U1.6 (PF0), X1.1 (OSC)
/Controller/OSC_OUT: C2.1, U1.7 (PF1), X1.3 (OSC)
/Controller/OUT1: U1.42 (OUT1); also elsewhere on the board
/Controller/OUT2: U1.39 (OUT2); also elsewhere on the board
/Controller/OUT3: U1.36 (OUT3); also elsewhere on the board
/Controller/REGIN: C14.2, R6.2, R7.2, R8.2, U1.64 (REGIN)
/Controller/SCREF: R3.2, R4.1, U1.52 (SCREF)
/Controller/STATUS_LED: R1.2, U1.53 (PD2)
/Controller/SW: D2.1 (K), L1.1, U1.62 (SW)
/Controller/SWCLK: J1.4, U1.50 (PA14)
/Controller/SWDIO: J1.3, U1.49 (PA13)
/Controller/VBUS_SENSE: U1.13 (PA0); also elsewhere on the board
GND: C1.2, C2.2, C3.2, C4.2, C5.2, C8.2, C11.2, C12.2, C13.2, C14.1, C15.2, D1.1, J1.2, NT1.2, R2.1, R4.2, U1.65 (VSS), X1.2 (GND), X1.4 (GND); also elsewhere on the board
unnamed: D1.2, R1.1
PGND: C6.2, C7.2, C9.2, C10.2, D2.2 (A), NT1.1, U1.32 (PGND); also elsewhere on the board
VCC: C9.1, C10.1, L1.2, R6.1, R7.1, R8.1, U1.63 (VCC)
VDDA: C11.1, C12.1, C13.1, C15.1, FB1.2, U1.26 (VREF+), U1.27 (VDDA)
VM: C6.1, C7.1, U1.61 (VM); also elsewhere on the board

Notes on the sheet:
Pg 18 Figure 10: LDO supplied with external resistors to reduce heat due to VCC running at 12V rather than default 8V
BOOT0 pulled low ensures boot into main flash instead of ST's built-in bootloader
Red LED (pin 53)
BOOT0 pulldown
SCREF (drain-source limit)
25MHz Crystal
NRST pull up
REG3V3 Output
VM (50V)
VCC (12V) Buck Regulator
VREF+ & VDDA
SWD Header
VBAT
REGIN (LDO input)

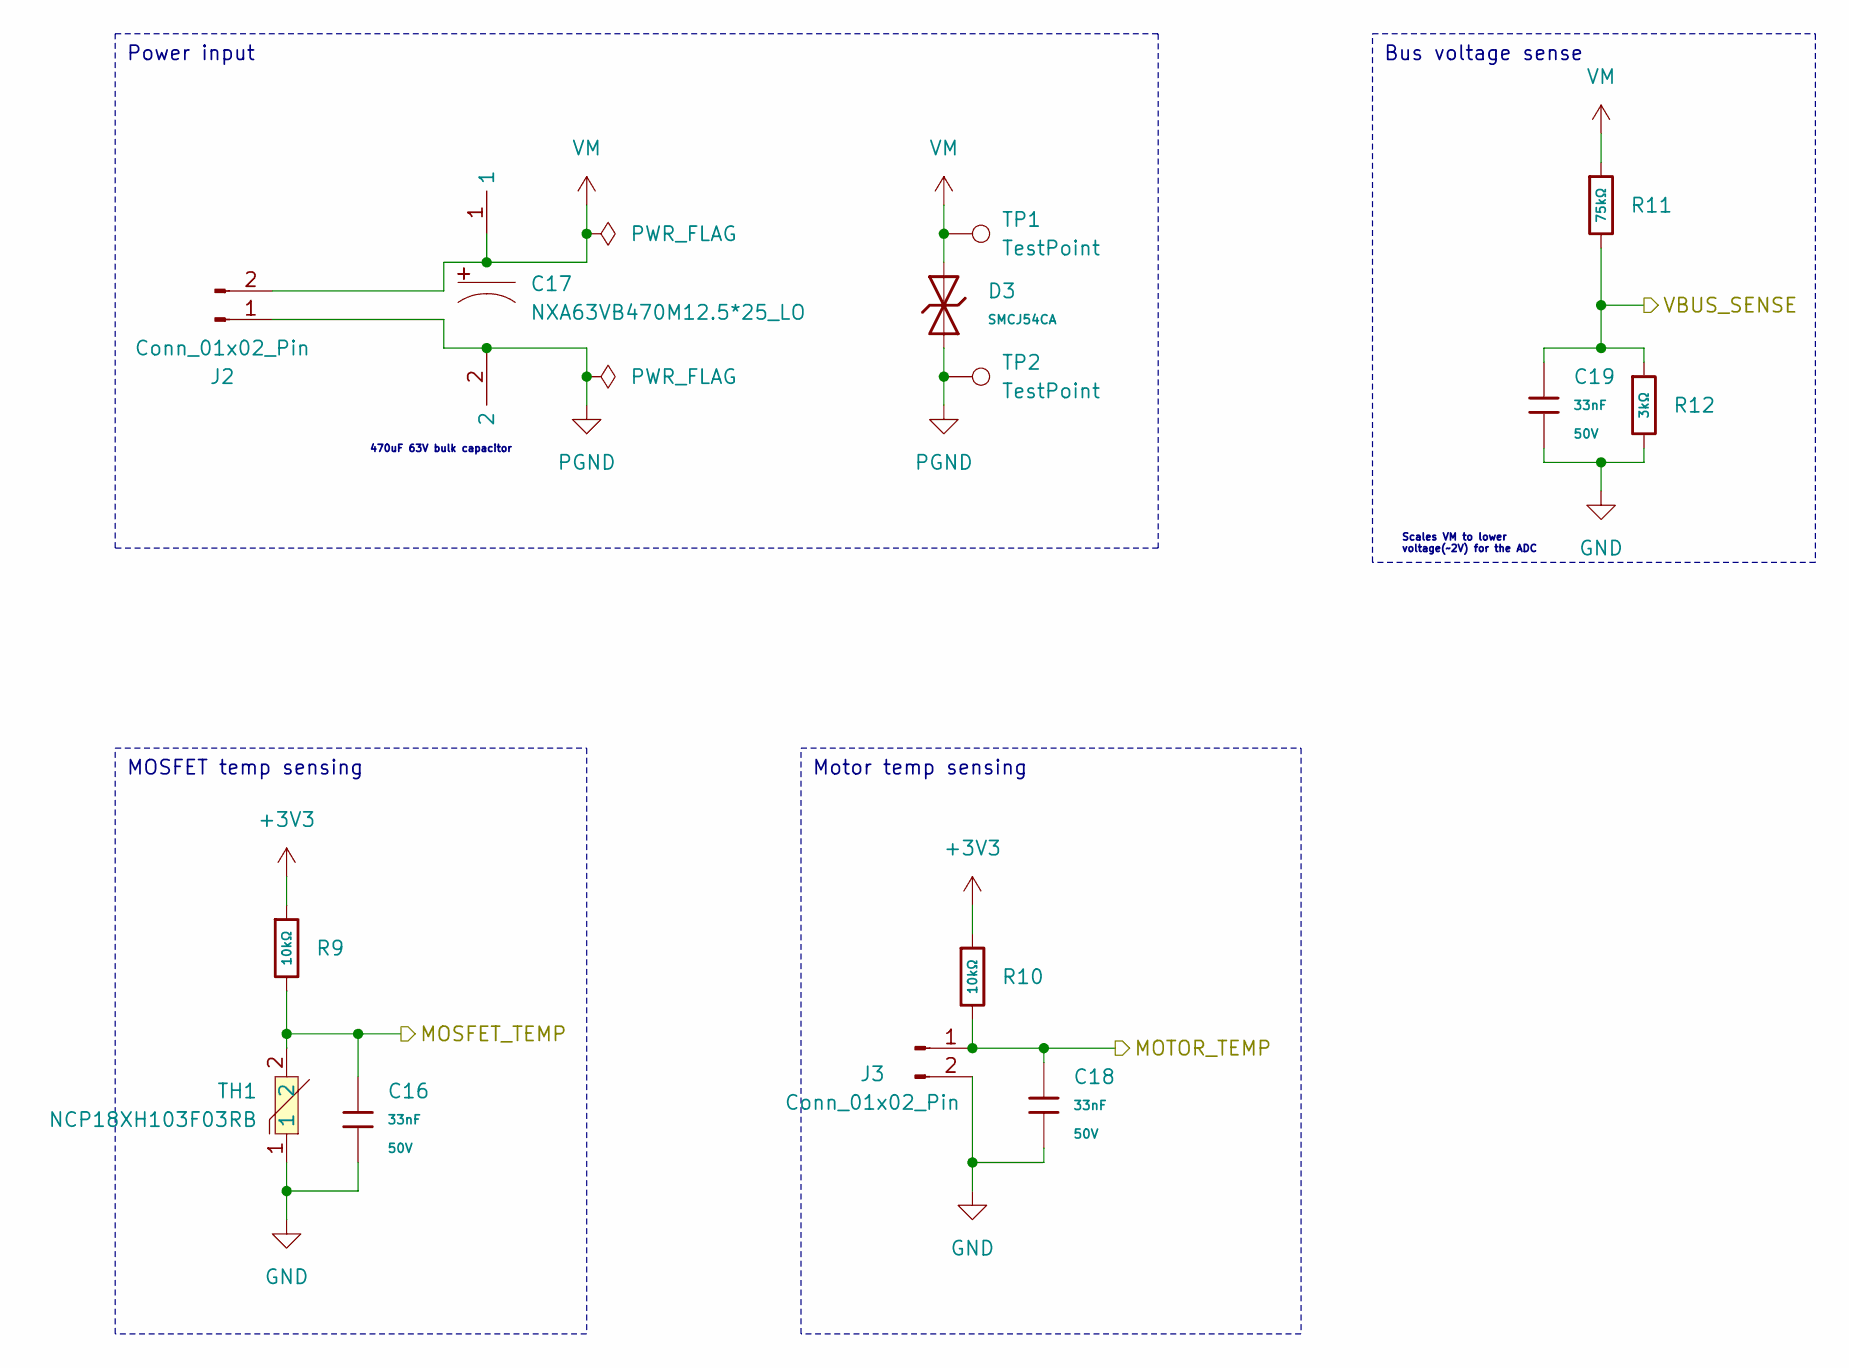
[picture p6: schematic power_input.kicad_sch]

Parts:
C16, C18, C19: 33nF; C_0603; Voltage Rated 50V; Tolerance ±10%; Part CL10B333KB8NNNC; LCSC C21117
C17: NXA63VB470M12.5*25_LO; CAP-TH_BD12.5-P5.00-D0.6-FD; MPN NXA63V470M12.5*25 LO; LCSC Part C371297
D3: SMCJ54CA; D_SMC; Clamping Voltage 87.1V; Voltage - Breakdown 66.3V; Part SMCJ54CA; LCSC C41411761
J2: Conn_01x02_Pin; AMASS_XT30PW-M_1x02_P2.50mm_Horizontal
J3: Conn_01x02_Pin; JST_GH_SM02B-GHS-TB_1x02-1MP_P1.25mm_Horizontal
R9, R10: 10kΩ; R_0402; Overload Voltage (Max) 50V; Tolerance ±1%; Part 0402WGF1002TCE; LCSC C25744
R11: 75kΩ; R_0603; Overload Voltage (Max) 75V; Tolerance ±1%; Part 0603WAF7502T5E; LCSC C23242
R12: 3kΩ; R_0603; Overload Voltage (Max) 75V; Tolerance ±1%; Part 0603WAF3001T5E; LCSC C4211
TH1: NCP18XH103F03RB; R0603; MPN NCP18XH103F03RB; LCSC Part C13564
TP1, TP2: TestPoint; TestPoint_Pad_1.5x1.5mm

Connections:
+3V3: R9.1, R10.1; also elsewhere on the board
/Controller/MOSFET_TEMP: C16.1, R9.2, TH1.2; also elsewhere on the board
/Controller/MOTOR_TEMP: C18.1, J3.1, R10.2; also elsewhere on the board
/Controller/VBUS_SENSE: C19.1, R11.2, R12.1; also elsewhere on the board
GND: C16.2, C18.2, C19.2, J3.2, R12.2, TH1.1; also elsewhere on the board
PGND: C17.2, D3.1, J2.1, TP2.1 (1_1); also elsewhere on the board
VM: C17.1, D3.2, J2.2, R11.1, TP1.1 (1_1); also elsewhere on the board

Notes on the sheet:
470uF 63V bulk capacitor
Scales VM to lower voltage(~2V) for the ADC
Motor temp sensing
MOSFET temp sensing
Bus voltage sense
Power input

Board: 4 copper layers, 121 parts (3 on the bottom side), 71 nets, no tracks yet.
