mungoP/ZABKA/(commit log)

2026-11-03 added project folder structiona, gitignore, and a BOM
2026-11-03 Updated gitignore; initialized KiCad PCB files for main board and motor boards
    [main_board.kicad_pcb, main_board.kicad_sch, motor_board.kicad_pcb, motor_board.kicad_sch]
2026-11-04 Added BOM google sheet link; motor board components in progress
2026-11-04 updated the BOM csv file from google sheet
    [BOM.csv]
2026-11-04 BOM for motor_board PCB
2026-11-04 Updated wording for motor board BOM
2026-11-04 Fixed heading in motor board BOM
2026-11-05 working on motor board PCB; imported custom parts from JLC's library into lib/
    [CAN_bus.kicad_sch, controller.kicad_sch, encoder.kicad_sch, half_bridge.kicad_sch, monitoring.kicad_sch, motor_board.kicad_sch, power_input.kicad_sch]
2026-11-06 Work on motor board: focusing on stspin32g4
    [controller.kicad_sch]
2026-11-07 small edits to main board PCB
    [main_board.kicad_sch]
2026-11-07 created BOM for main board: STM32G474 for MCU, BMI088 as IMU
2026-11-07 Mtr ctrl: decoupling caps; set design rules/constraints/board layer layout for JLC economic PCB assembly
    [controller.kicad_sch, motor_board.kicad_pcb]
2026-11-08 finished decoupling for motor board; added datasheets for multiple ICs
    [controller.kicad_sch]
2026-11-08 motor controller small changes
    [controller.kicad_sch]
2026-11-08 added net labels and no-connect flags
    [controller.kicad_sch]
2026-11-09 organizing schematic with text boxes
    [controller.kicad_sch]
2026-11-09 small changes to motor controller PCB
    [controller.kicad_sch]
2026-11-09 finish controller for motor ctrl; uploaded crystal documentation
    [controller.kicad_sch]
2026-11-09 fixed buck converter; adding power_flags (have to go home)
    [controller.kicad_sch]
2026-11-10 rearranging schematic
    [controller.kicad_sch]
2026-11-11 Motor controller: controll unit, power and monitor finished; uploaded custom part and datasheets
    [controller.kicad_sch, motor_board.kicad_sch, power_input.kicad_sch]
2026-11-11 finished CAN bus; encoder IP; datasheets for encoder and CAN transceiver
    [CAN_bus.kicad_sch, controller.kicad_sch, encoder.kicad_sch, motor_board.kicad_sch, power_input.kicad_sch]
2026-11-11 encoder finished; half-bridge IP
    [CAN_bus.kicad_sch, controller.kicad_sch, encoder.kicad_sch, half_bridge.kicad_sch, motor_board.kicad_sch]
2026-11-12 made CAN passthrough more clear
    [CAN_bus.kicad_sch]
2026-11-12 finalized motor controller schematic, everything looks done
    [controller.kicad_sch, half_bridge.kicad_sch, motor_board.kicad_sch, power_input.kicad_sch]
2026-11-12 fixed an annotation; imported the rats nest into the pcb (some parts missing footprints will need to fix)
    [controller.kicad_sch, motor_board.kicad_pcb, power_input.kicad_sch]
2026-11-12 fixed can pass through symbol from U to J, fixed wording of a note
    [CAN_bus.kicad_sch, controller.kicad_sch, motor_board.csv]
2026-11-12 motor board BOM updated
2026-11-12 updated ref for CAN connectors
    [CAN_bus.kicad_sch]
2026-11-12 working on schematic
    [CAN_bus.kicad_sch, controller.kicad_sch, half_bridge.kicad_sch, motor_board.kicad_pcb, power_input.kicad_sch]
2026-11-13 added amass xt30 m connector to lib
    [motor_board.kicad_pcb]
